Tejlilboy/QuadBot/Hardware/BOM/QuadBot_BOM.csv

Item | Category | Qty | Reference | Component | Specification | Notes | Supplier | Link | Unit Price (USD)
1 | Controller | 1 | U1 | Seeed Studio XIAO ESP32-S3 | ESP32-S3 microcontroller, Wi-Fi + Bluetooth LE | Microcontroller that handles all logic
2 | Display | 1 | DISP1 | OLED display | SSD1306, 128x64, I2C, address 0x3C | 4-pin module (GND, VCC, SCL, SDA). Connects through the 1x4 header.
3 | Actuators | 8 | R1-R4, L1-L4 | Micro servo motor | MG90S | 4 hip servos and 4 lift servos (see servo map in README).
4 | Power | 1 | BT1 | Li-ion battery pack, 2S | Blomiky, 7.4 V, 800 mAh | Comes with a female T-plug connector.
5 | Power | 1 | SW1 | Rocker switch | On/off power switch | 12V+.
6 | Power | 1 | U2 | Buck converter (step-down) | Output 5 V, 3 A | Steps the 7.4 V battery down to 5 V for the servos and logic.
7 | Power | 1 | C1 | Electrolytic capacitor | 1000 uF | Bulk capacitor on the 5 V rail. 12 Volts
8 | Power | 1 | PCB1 | Custom power distribution PCB | Designed for QuadBot | Custom design (see the PCB images in the README).
9 | Connectors | 1 | J11 | T-plug connector, male | T-plug (Deans-style) | Mates with the battery's female T-plug.
10 | Connectors | 8 | J1-J8 | Pin header, 1x3, male | 2.54 mm pitch | One per servo (signal, power, ground).
11 | Connectors | 1 | J9 | Pin header, 1x2, male | 2.54 mm pitch | Power from buck converter
12 | Connectors | 1 | J10 | Pin header, 1x4, male | 2.54 mm pitch | For the OLED display.
13 | Wiring | 1 | - | Hook-up wire | 20 AWG | Standard Color Cod ing
