Tejlilboy/QuadBot/Hardware/STL Files/L3-v117.stl

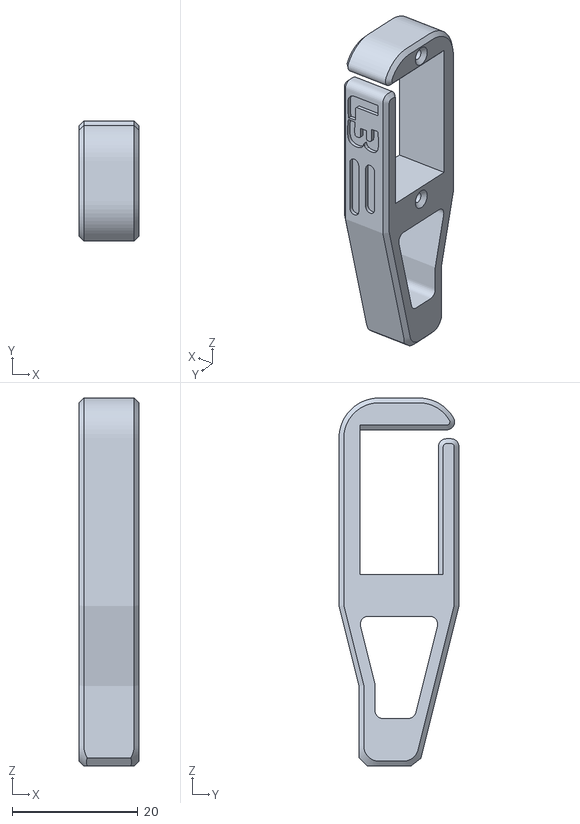
[picture p7: CAD file, 2026-11-06]
Hardware/STL Files/L3-v117.stl
9.53 x 19.0 x 58.4
