Tejlilboy/QuadBot/Hardware/STL Files/L2-v117.stl

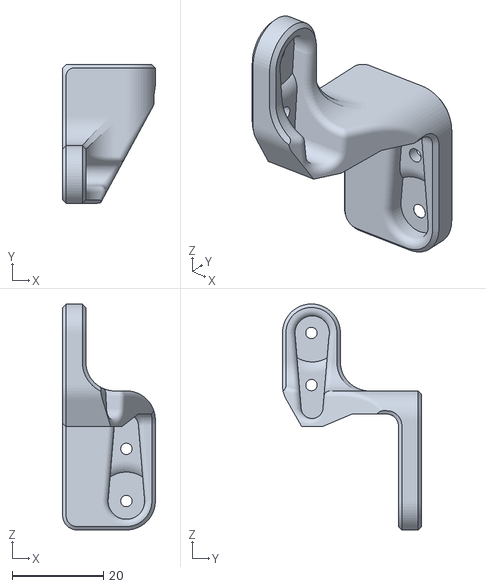
[picture p8: CAD file, 2026-11-06]
Hardware/STL Files/L2-v117.stl
20.3 x 30.5 x 49.5
