Tejlilboy/QuadBot/Hardware/STL Files/Internal-Frame-v121.stl

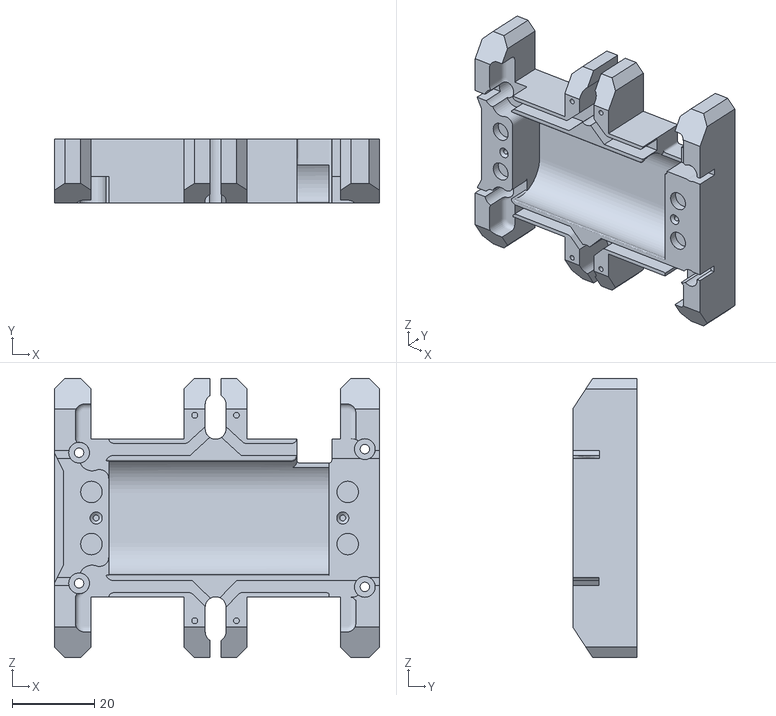
[picture p9: CAD file, 2026-11-06]
Hardware/STL Files/Internal-Frame-v121.stl
79.2 x 15.7 x 68.1
