Tejlilboy/QuadBot/Hardware/STL Files/Bottom-Cover-v121.stl

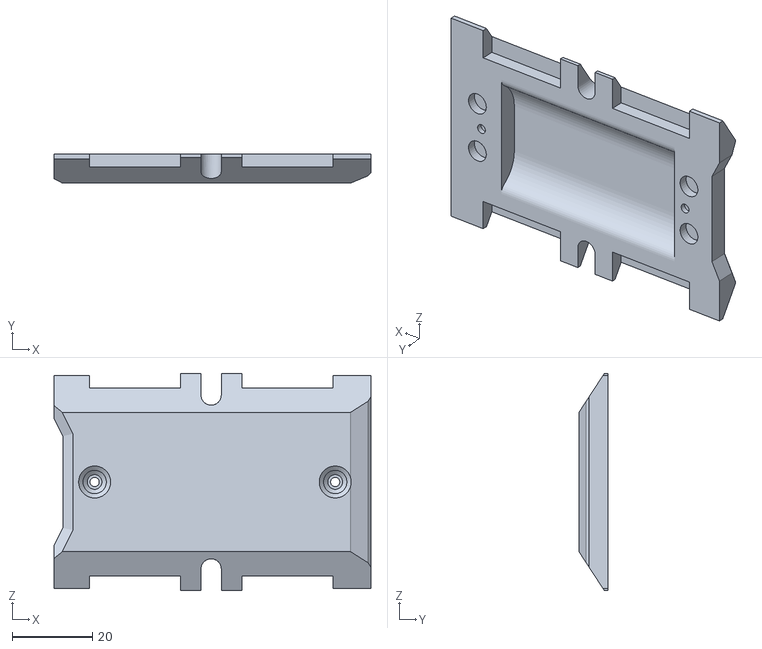
[picture p10: CAD file, 2026-11-06]
Hardware/STL Files/Bottom-Cover-v121.stl
79.2 x 7.27 x 54.2
