Tejlilboy/QuadBot/Hardware/STL Files/Cover-modified.stl

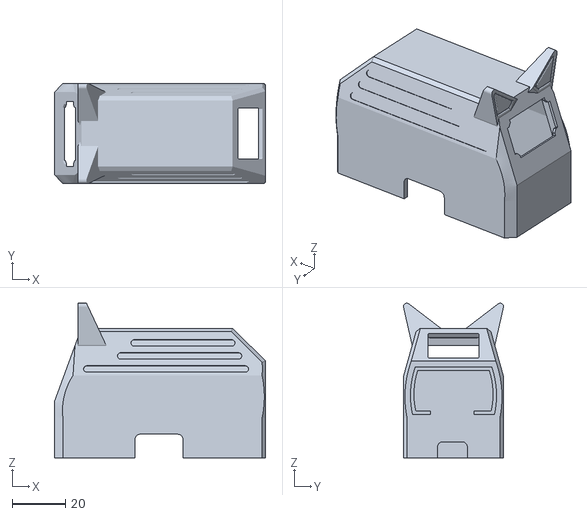
[picture p11: CAD file, 2026-11-06]
Hardware/STL Files/Cover-modified.stl
79.2 x 37.6 x 58.1
