Tejlilboy/QuadBot/(list of files, cad)

Other CAD files:
Hardware/STL Files/L1-v117.stl
Hardware/STL Files/R1-v117.stl
Hardware/STL Files/R2-v117.stl
Hardware/STL Files/R4-v117.stl
Hardware/STL Files/L4-v117.stl
Hardware/STL Files/R3-v117.stl
