Tejlilboy/QuadBot/(commit log)

2026-11-06 Added more files
    [Bottom-Cover-v121.stl, Internal-Frame-v121.stl, L1-v117.stl, L2-v117.stl, L3-v117.stl, L4-v117.stl, PCBWay_bom.csv, PCBWay_positions.csv]
2026-11-07 Added Android application build files along with BOM
    [QuadBot_BOM.csv]
2026-11-07 Revise QuadBot BOM with updated details
    Updated the BOM with corrected specifications and notes for components.
    [QuadBot_BOM.csv]
